CarnivalBen/dmx-eth-dimmer/pcb/plots-toner/dmx-eth-dimmer-B.Cu.pdf

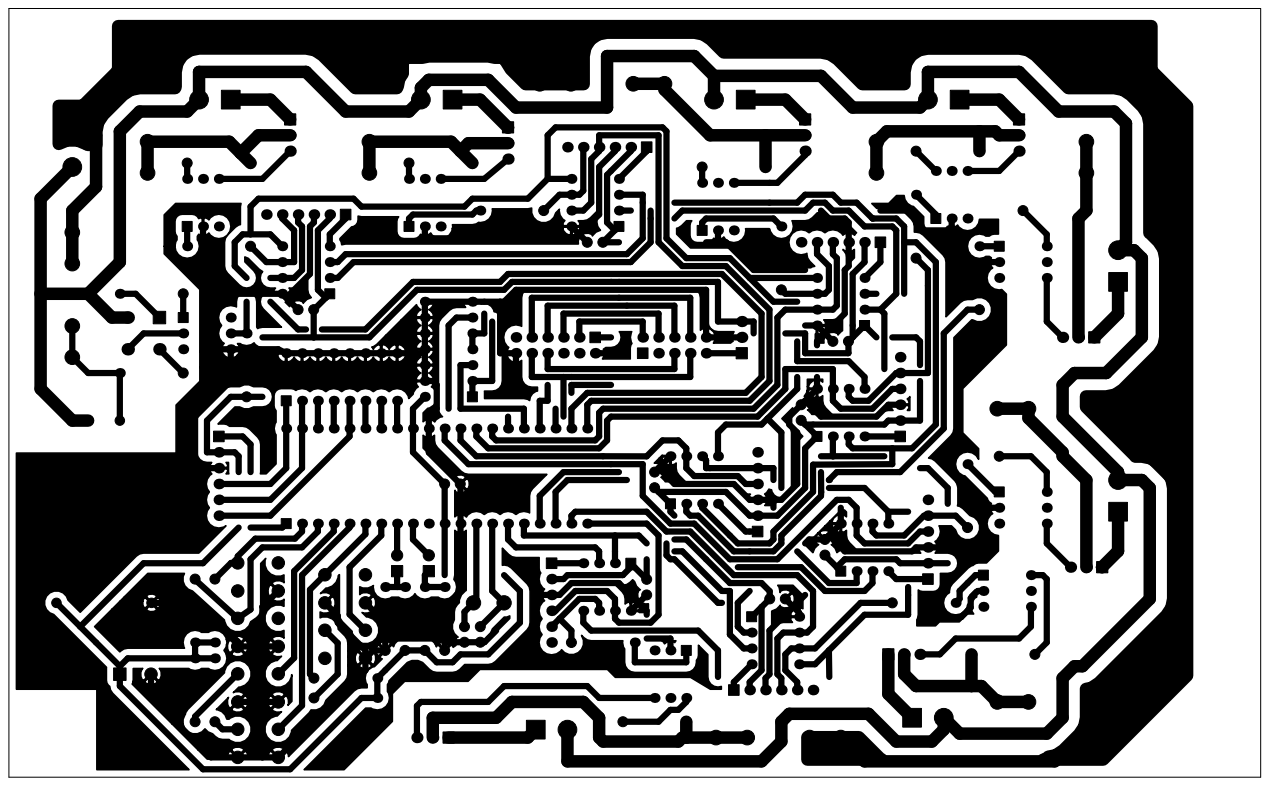
[picture p1: page 1]
