CarnivalBen/dmx-eth-dimmer/pcb/plots-toner/dmx-eth-dimmer-F.SilkS.pdf

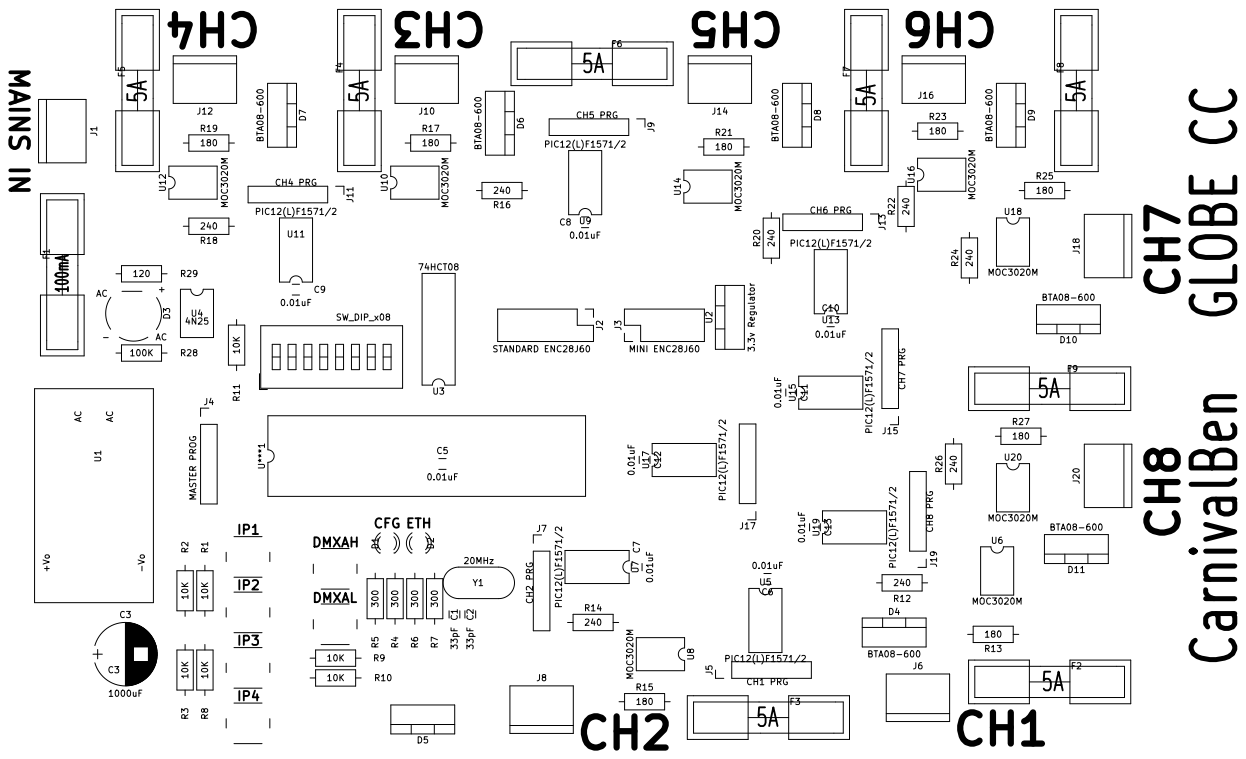
[picture p2: page 1]
