CarnivalBen/dmx-eth-dimmer/pcb/dmx-eth-dimmer.kicad_pcb

## KiCad design pcb/dmx-eth-dimmer.kicad_pcb (2018-09-09)

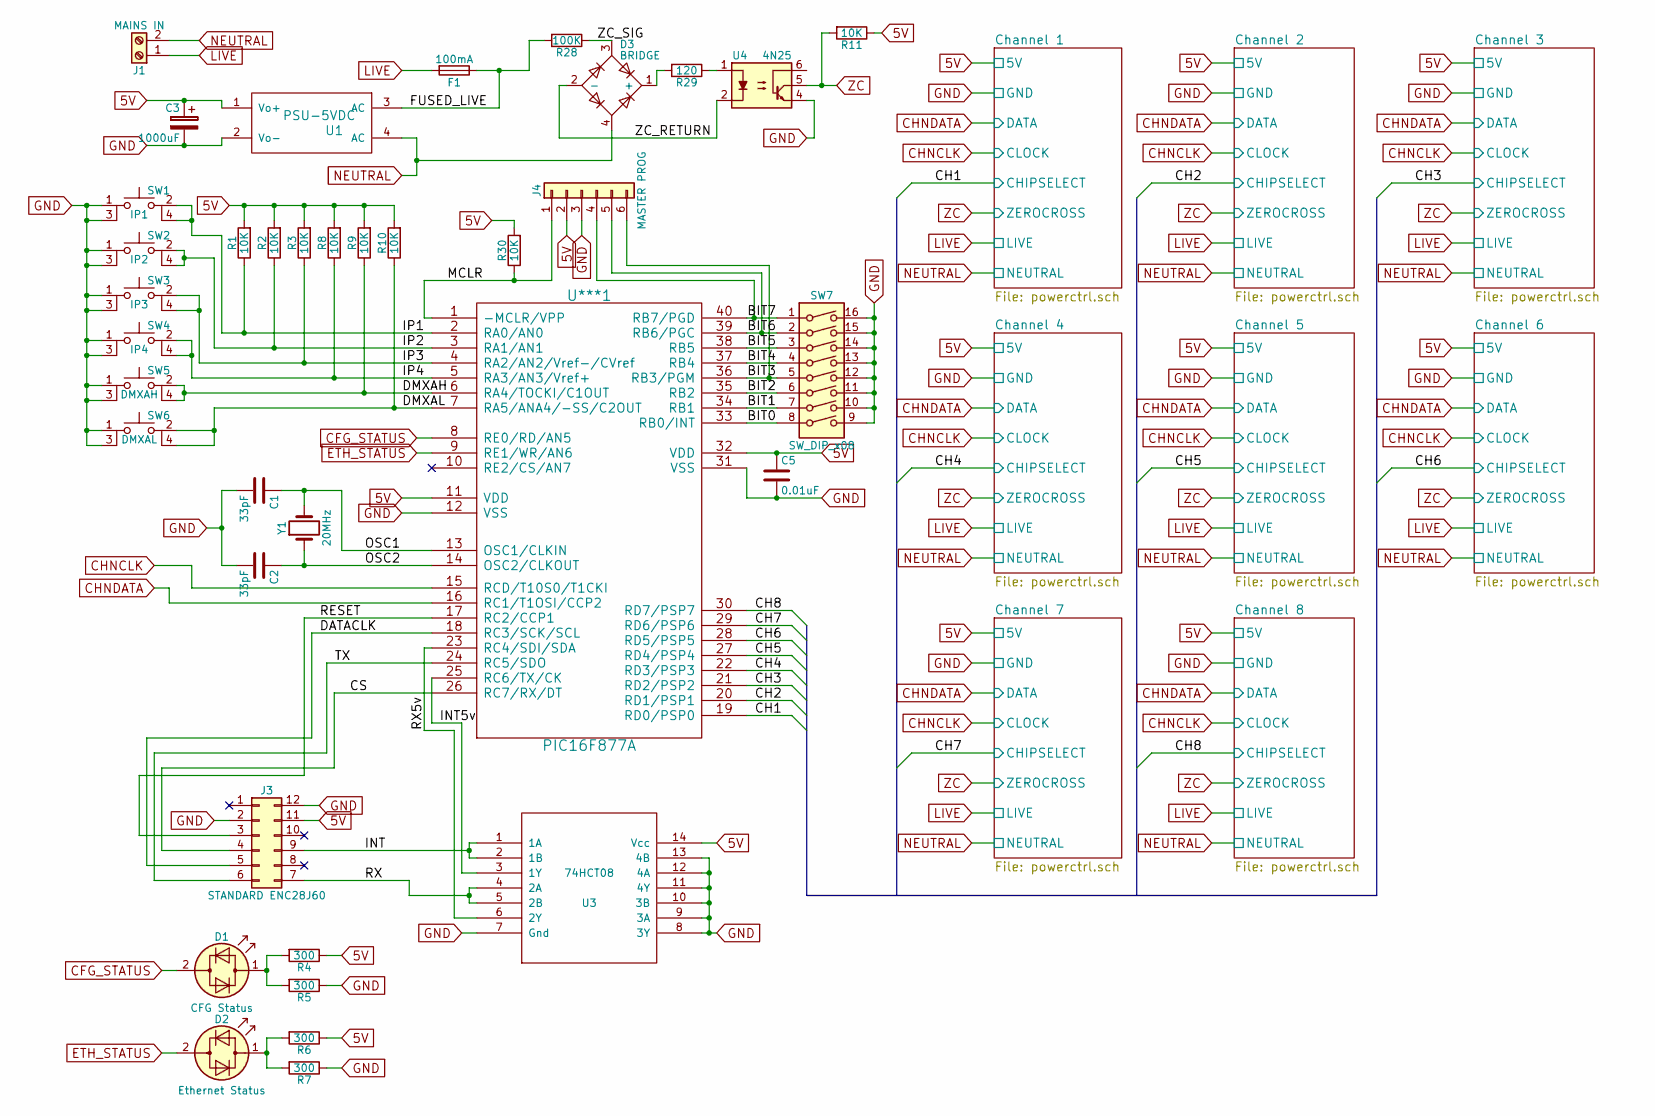
[picture p3: schematic dmx-eth-dimmer.sch]

Parts:
C1, C2: 33pF; C_Disc_D3.0mm_W1.6mm_P2.50mm
C3: 1000uF; CP_Radial_D10.0mm_P5.00mm
C5: 0.01uF; C_Disc_D3.0mm_W1.6mm_P2.50mm
D1: CFG Status; LED_D3.0mm
D2: Ethernet Status; LED_D3.0mm
D3: BRIDGE; Diode_Bridge_W08
F1: 100mA; Fuseholder5x20_horiz_open_inline_Type-I
J1: MAINS IN; TerminalBlock_bornier-2_P5.08mm
J3: STANDARD ENC28J60; Pin_Header_Straight_2x06_Pitch2.54mm
J4: MASTER PROG; Pin_Header_Straight_1x06_Pitch2.54mm
R1, R2, R3, R8, R9, R10, R11, R30: 10K; R_Axial_DIN0207_L6.3mm_D2.5mm_P10.16mm_Horizontal
R4, R5, R6, R7: 300; R_Axial_DIN0207_L6.3mm_D2.5mm_P10.16mm_Horizontal
R28: 100K; R_Axial_DIN0207_L6.3mm_D2.5mm_P10.16mm_Horizontal
R29: 120; R_Axial_DIN0207_L6.3mm_D2.5mm_P10.16mm_Horizontal
SW1: IP1; SW_PUSH_6mm_4pin
SW2: IP2; SW_PUSH_6mm_4pin
SW3: IP3; SW_PUSH_6mm_4pin
SW4: IP4; SW_PUSH_6mm_4pin
SW5: DMXAH; SW_PUSH_6mm_4pin
SW6: DMXAL; SW_PUSH_6mm_4pin
SW7: SW_DIP_x08; SW_DIP_x8_W7.62mm_Slide
U1: PSU-5VDC; HLK-PM01
U3: 74HCT08; DIP-14_W7.62mm
U4: 4N25; DIP-6_W7.62mm
U***1: PIC16F877A; DIP-40_W15.24mm
Y1: 20MHz; Crystal_HC50_Vertical

Connections:
5V: C3.1, C5.1, J3.11, J4.2, R1.2, R2.2, R3.2, R4.1, R6.1, R8.2, R9.2, R10.2, R11.1, R30.2, U1.1 (Vo+), U3.14 (Vcc), U***1.11 (VDD), U***1.32 (VDD); also elsewhere on the board
/BIT0: SW7.8, U***1.33 (RB0/INT)
/BIT1: SW7.7, U***1.34 (RB1)
/BIT2: SW7.6, U***1.35 (RB2)
/BIT3: J4.6, SW7.5, U***1.36 (RB3/PGM)
/BIT4: SW7.4, U***1.37 (RB4)
/BIT5: SW7.3, U***1.38 (RB5)
/BIT6: J4.5, SW7.2, U***1.39 (RB6/PGC)
/BIT7: J4.4, SW7.1, U***1.40 (RB7/PGD)
/CH1: U***1.19 (RD0/PSP0); also elsewhere on the board
/CH2: U***1.20 (RD1/PSP1); also elsewhere on the board
/CH3: U***1.21 (RD2/PSP2); also elsewhere on the board
/CH4: U***1.22 (RD3/PSP3); also elsewhere on the board
/CH5: U***1.27 (RD4/PSP4); also elsewhere on the board
/CH6: U***1.28 (RD5/PSP5); also elsewhere on the board
/CH7: U***1.29 (RD6/PSP6); also elsewhere on the board
/CH8: U***1.30 (RD7/PSP7); also elsewhere on the board
/CS: J3.4, U***1.26 (RC7/RX/DT)
/DATACLK: J3.5, U***1.18 (RC3/SCK/SCL)
/DMXAH: R9.1, SW5.2, SW5.4, U***1.6 (RA4/TOCKI/C1OUT)
/DMXAL: R10.1, SW6.2, SW6.4, U***1.7 (RA5/ANA4/-SS/C2OUT)
/FUSED_LIVE: F1.1, R28.2, U1.3 (AC)
/INT: J3.9, U3.1 (1A), U3.2 (1B)
/INT5v: U3.3 (1Y), U***1.25 (RC6/TX/CK)
/IP1: R1.1, SW1.2, SW1.4, U***1.2 (RA0/AN0)
/IP2: R2.1, SW2.2, SW2.4, U***1.3 (RA1/AN1)
/IP3: R3.1, SW3.2, SW3.4, U***1.4 (RA2/AN2/Vref-/CVref)
/IP4: R8.1, SW4.2, SW4.4, U***1.5 (RA3/AN3/Vref+)
/MCLR: J4.1, R30.1, U***1.1 (-MCLR/VPP)
/OSC1: C1.1, U***1.13 (OSC1/CLKIN), Y1.2
/OSC2: C2.1, U***1.14 (OSC2/CLKOUT), Y1.1
/RESET: J3.3, U***1.17 (RC2/CCP1)
/RX: J3.7, U3.4 (2A), U3.5 (2B)
/RX5v: U3.6 (2Y), U***1.23 (RC4/SDI/SDA)
/TX: J3.6, U***1.24 (RC5/SDO)
/ZC_RETURN: D3.2 (-), U4.2
/ZC_SIG: D3.3, R28.1
CFG_STATUS: D1.2 (AK), U***1.8 (RE0/RD/AN5)
CHNCLK: U***1.15 (RCD/T10S0/T1CKI); also elsewhere on the board
CHNDATA: U***1.16 (RC1/T1OSI/CCP2); also elsewhere on the board
ETH_STATUS: D2.2 (AK), U***1.9 (RE1/WR/AN6)
GND: C1.2, C2.2, C3.2, C5.2, J3.2, J3.12, J4.3, R5.1, R7.1, SW1.1, SW1.3, SW2.1, SW2.3, SW3.1, SW3.3, SW4.1, SW4.3, SW5.1, SW5.3, SW6.1, SW6.3, SW7.9, SW7.10, SW7.11, SW7.12, SW7.13, SW7.14, SW7.15, SW7.16, U1.2 (Vo-), U3.7 (Gnd), U3.8 (3Y), U3.9 (3A), U3.10 (3B), U3.11 (4Y), U3.12 (4A), U3.13 (4B), U4.4, U***1.12 (VSS), U***1.31 (VSS); also elsewhere on the board
LIVE: F1.2, J1.1; also elsewhere on the board
NEUTRAL: D3.4, J1.2, U1.4 (AC); also elsewhere on the board
unnamed: D1.1 (KA), R4.2, R5.2
unnamed: D2.1 (KA), R6.2, R7.2
unnamed: D3.1 (+), R29.2
unnamed: R29.1, U4.1
ZC: R11.2, U4.5; also elsewhere on the board

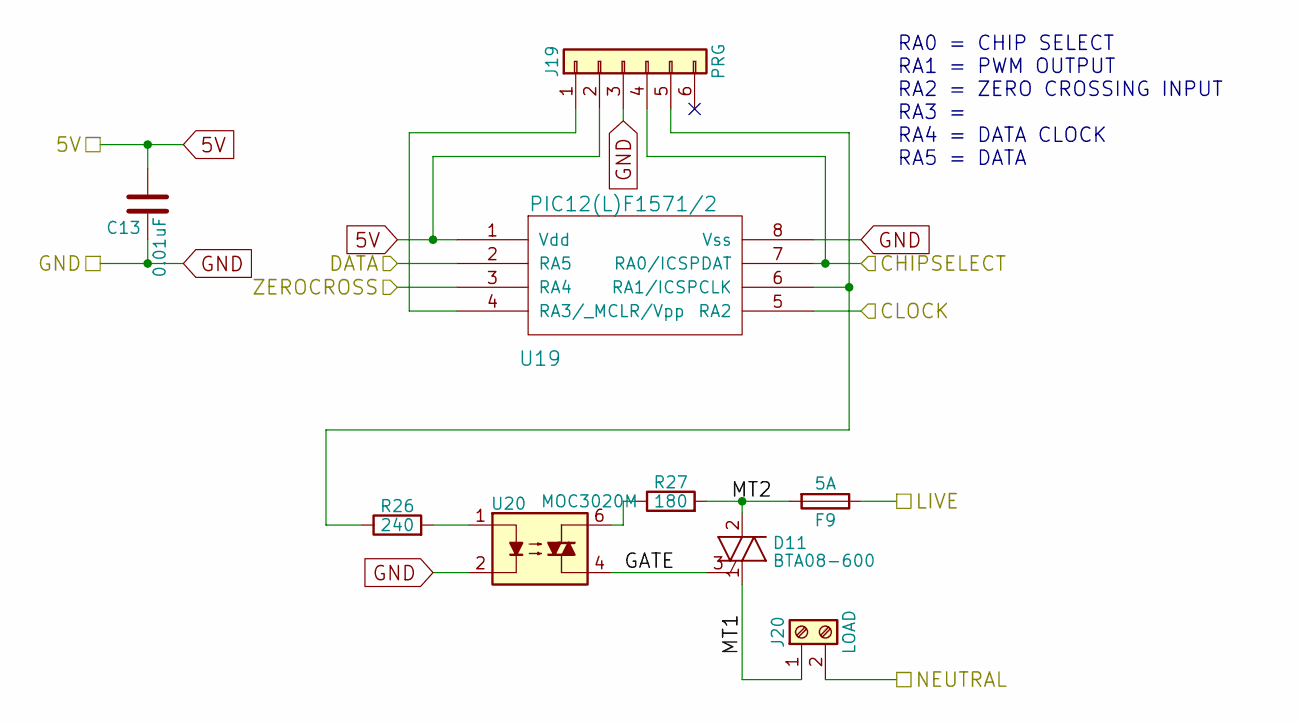
[picture p4: schematic powerctrl.sch]

Parts:
C6: 0.01uF; C_Disc_D3.0mm_W1.6mm_P2.50mm
D4: BTA08-600; TO-220-3_Vertical
F2: 5A; Fuseholder5x20_horiz_open_inline_Type-I
J5: PRG; Pin_Header_Straight_1x06_Pitch2.54mm
J6: LOAD; TerminalBlock_bornier-2_P5.08mm
R12: 240; R_Axial_DIN0207_L6.3mm_D2.5mm_P10.16mm_Horizontal
R13: 180; R_Axial_DIN0207_L6.3mm_D2.5mm_P10.16mm_Horizontal
U5: PIC12(L)F1571/2; DIP-8_W7.62mm
U6: MOC3020M; DIP-6_W7.62mm

Connections:
5V: C6.2, J5.2, U5.1 (Vdd); also elsewhere on the board
/CH1: J5.4, U5.7 (RA0/ICSPDAT); also elsewhere on the board
/Channel 1/GATE: D4.3 (G), U6.4
/Channel 1/MT1: D4.1 (MT1), J6.1
/Channel 1/MT2: D4.2 (MT2), F2.2, R13.2
CHNCLK: U5.5 (RA2); also elsewhere on the board
CHNDATA: U5.2 (RA5); also elsewhere on the board
GND: C6.1, J5.3, U5.8 (Vss), U6.2; also elsewhere on the board
LIVE: F2.1; also elsewhere on the board
NEUTRAL: J6.2; also elsewhere on the board
unnamed: J5.1, U5.4 (RA3/_MCLR/Vpp)
unnamed: J5.5, R12.1, U5.6 (RA1/ICSPCLK)
unnamed: R12.2, U6.1
unnamed: R13.1, U6.6
ZC: U5.3 (RA4); also elsewhere on the board

Parts of its further copies:
C7, C8, C9, C10, C11, C12, C13: 0.01uF; C_Disc_D3.0mm_W1.6mm_P2.50mm
D5, D6, D7, D8, D9, D10, D11: BTA08-600; TO-220-3_Vertical
F3, F4, F5, F6, F7, F8, F9: 5A; Fuseholder5x20_horiz_open_inline_Type-I
J7, J9, J11, J13, J15, J17, J19: PRG; Pin_Header_Straight_1x06_Pitch2.54mm
J8, J10, J12, J14, J16, J18, J20: LOAD; TerminalBlock_bornier-2_P5.08mm
R14, R16, R18, R20, R22, R24, R26: 240; R_Axial_DIN0207_L6.3mm_D2.5mm_P10.16mm_Horizontal
R15, R17, R19, R21, R23, R25, R27: 180; R_Axial_DIN0207_L6.3mm_D2.5mm_P10.16mm_Horizontal
U7, U9, U11, U13, U15, U17, U19: PIC12(L)F1571/2; DIP-8_W7.62mm
U8, U10, U12, U14, U16, U18, U20: MOC3020M; DIP-6_W7.62mm

Connections of its further copies:
5V: C7.2, C8.2, C9.2, C10.2, C11.2, C12.2, C13.2, J7.2, J9.2, J11.2, J13.2, J15.2, J17.2, J19.2, U7.1 (Vdd), U9.1 (Vdd), U11.1 (Vdd), U13.1 (Vdd), U15.1 (Vdd), U17.1 (Vdd), U19.1 (Vdd); also elsewhere on the board
/CH2: J7.4, U7.7 (RA0/ICSPDAT); also elsewhere on the board
/CH3: J9.4, U9.7 (RA0/ICSPDAT); also elsewhere on the board
/CH4: J11.4, U11.7 (RA0/ICSPDAT); also elsewhere on the board
/CH5: J13.4, U13.7 (RA0/ICSPDAT); also elsewhere on the board
/CH6: J15.4, U15.7 (RA0/ICSPDAT); also elsewhere on the board
/CH7: J17.4, U17.7 (RA0/ICSPDAT); also elsewhere on the board
/CH8: J19.4, U19.7 (RA0/ICSPDAT); also elsewhere on the board
/Channel 2/GATE: D5.3 (G), U8.4
/Channel 2/MT1: D5.1 (MT1), J8.1
/Channel 2/MT2: D5.2 (MT2), F3.2, R15.2
/Channel 3/GATE: D6.3 (G), U10.4
/Channel 3/MT1: D6.1 (MT1), J10.1
/Channel 3/MT2: D6.2 (MT2), F4.2, R17.2
/Channel 4/GATE: D7.3 (G), U12.4
/Channel 4/MT1: D7.1 (MT1), J12.1
/Channel 4/MT2: D7.2 (MT2), F5.2, R19.2
/Channel 5/GATE: D8.3 (G), U14.4
/Channel 5/MT1: D8.1 (MT1), J14.1
/Channel 5/MT2: D8.2 (MT2), F6.2, R21.2
/Channel 6/GATE: D9.3 (G), U16.4
/Channel 6/MT1: D9.1 (MT1), J16.1
/Channel 6/MT2: D9.2 (MT2), F7.2, R23.2
/Channel 7/GATE: D10.3 (G), U18.4
/Channel 7/MT1: D10.1 (MT1), J18.1
/Channel 7/MT2: D10.2 (MT2), F8.2, R25.2
/Channel 8/GATE: D11.3 (G), U20.4
/Channel 8/MT1: D11.1 (MT1), J20.1
/Channel 8/MT2: D11.2 (MT2), F9.2, R27.2
CHNCLK: U7.5 (RA2), U9.5 (RA2), U11.5 (RA2), U13.5 (RA2), U15.5 (RA2), U17.5 (RA2), U19.5 (RA2); also elsewhere on the board
CHNDATA: U7.2 (RA5), U9.2 (RA5), U11.2 (RA5), U13.2 (RA5), U15.2 (RA5), U17.2 (RA5), U19.2 (RA5); also elsewhere on the board
GND: C7.1, C8.1, C9.1, C10.1, C11.1, C12.1, C13.1, J7.3, J9.3, J11.3, J13.3, J15.3, J17.3, J19.3, U7.8 (Vss), U8.2, U9.8 (Vss), U10.2, U11.8 (Vss), U12.2, U13.8 (Vss), U14.2, U15.8 (Vss), U16.2, U17.8 (Vss), U18.2, U19.8 (Vss), U20.2; also elsewhere on the board
LIVE: F3.1, F4.1, F5.1, F6.1, F7.1, F8.1, F9.1; also elsewhere on the board
NEUTRAL: J8.2, J10.2, J12.2, J14.2, J16.2, J18.2, J20.2; also elsewhere on the board
unnamed: J7.1, U7.4 (RA3/_MCLR/Vpp)
unnamed: J7.5, R14.1, U7.6 (RA1/ICSPCLK)
unnamed: J9.1, U9.4 (RA3/_MCLR/Vpp)
unnamed: J9.5, R16.1, U9.6 (RA1/ICSPCLK)
unnamed: J11.1, U11.4 (RA3/_MCLR/Vpp)
unnamed: J11.5, R18.1, U11.6 (RA1/ICSPCLK)
unnamed: J13.1, U13.4 (RA3/_MCLR/Vpp)
unnamed: J13.5, R20.1, U13.6 (RA1/ICSPCLK)
unnamed: J15.1, U15.4 (RA3/_MCLR/Vpp)
unnamed: J15.5, R22.1, U15.6 (RA1/ICSPCLK)
unnamed: J17.1, U17.4 (RA3/_MCLR/Vpp)
unnamed: J17.5, R24.1, U17.6 (RA1/ICSPCLK)
unnamed: J19.1, U19.4 (RA3/_MCLR/Vpp)
unnamed: J19.5, R26.1, U19.6 (RA1/ICSPCLK)
unnamed: R14.2, U8.1
unnamed: R15.1, U8.6
unnamed: R16.2, U10.1
unnamed: R17.1, U10.6
unnamed: R18.2, U12.1
unnamed: R19.1, U12.6
unnamed: R20.2, U14.1
unnamed: R21.1, U14.6
unnamed: R22.2, U16.1
unnamed: R23.1, U16.6
unnamed: R24.2, U18.1
unnamed: R25.1, U18.6
unnamed: R26.2, U20.1
unnamed: R27.1, U20.6
ZC: U7.3 (RA4), U9.3 (RA4), U11.3 (RA4), U13.3 (RA4), U15.3 (RA4), U17.3 (RA4), U19.3 (RA4); also elsewhere on the board

Notes on the sheet:
RA0 = CHIP SELECT RA1 = PWM OUTPUT RA2 = ZERO CROSSING INPUT RA3 = RA4 = DATA CLOCK RA5 = DATA

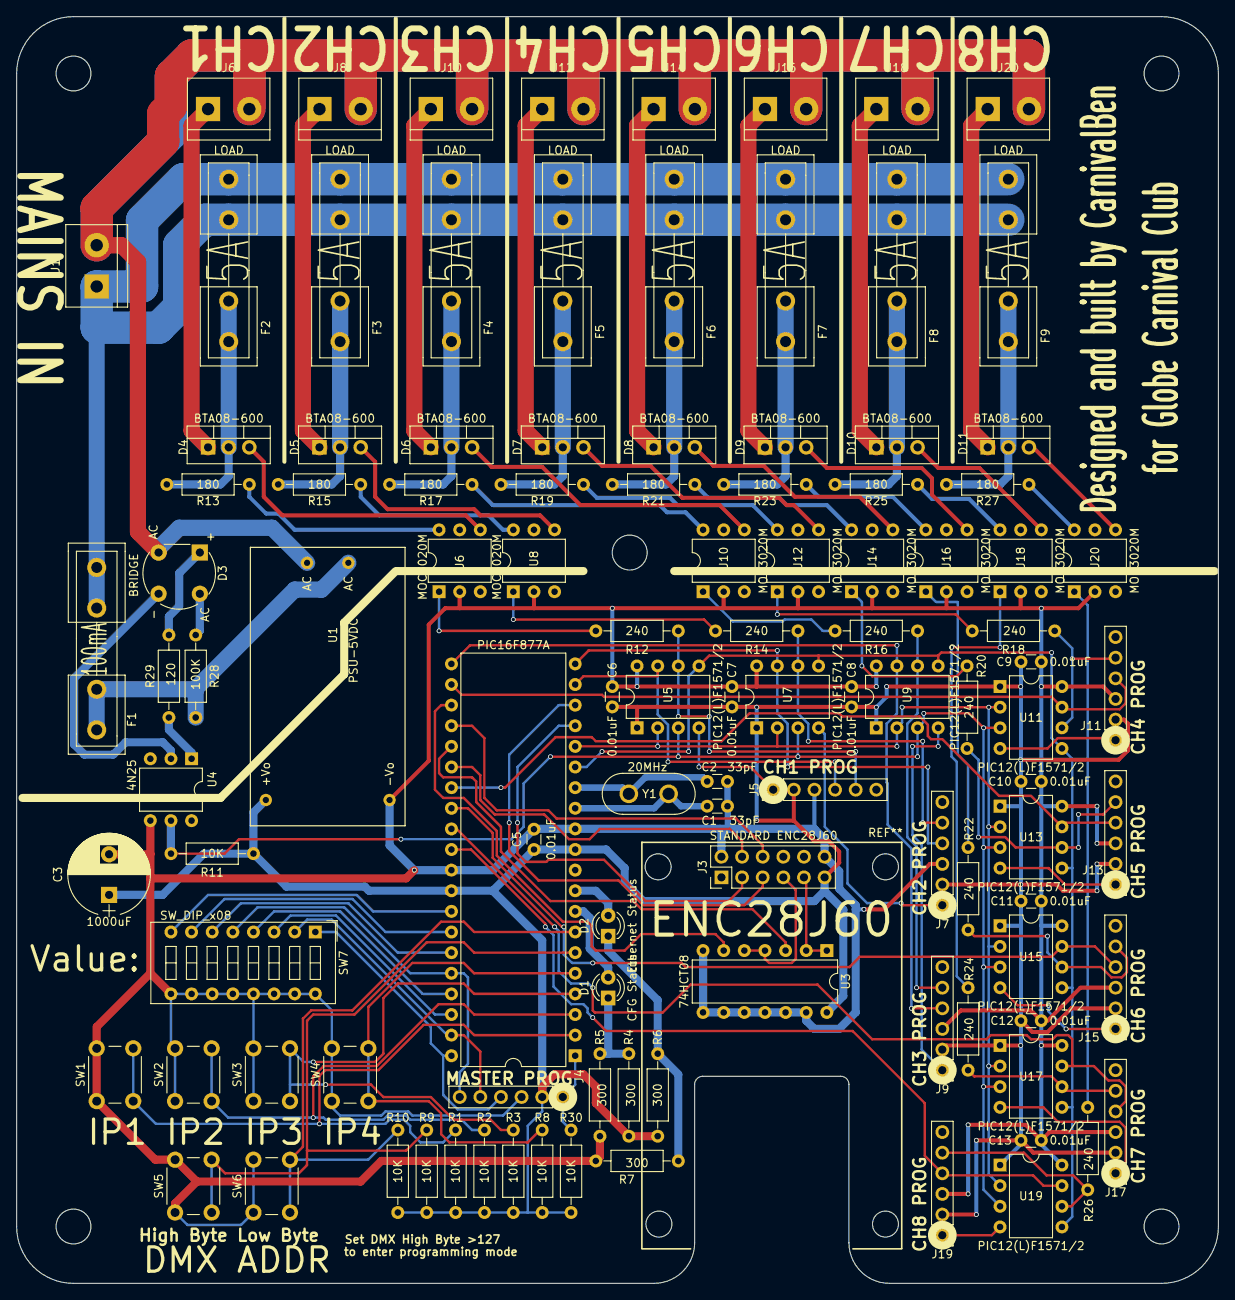
[picture p5: board dmx-eth-dimmer.kicad_pcb from above]

Board: 2 copper layers, 148.0 x 156.0 mm, 109 parts (0 on the bottom side), 105 nets.
