CarnivalBen/dmx-eth-dimmer/(commit log)

2018-06-18 Update to PCB
    [dmx-eth-dimmer-B.Cu.gbr, dmx-eth-dimmer-B.Mask.gbr, dmx-eth-dimmer-B.SilkS.gbr, dmx-eth-dimmer-Edge.Cuts.gbr, dmx-eth-dimmer-F.Cu.gbr, dmx-eth-dimmer-F.Mask.gbr, dmx-eth-dimmer-F.SilkS.gbr, dmx-eth-dimmer-NPTH.drl]
2018-06-26 Updated PCB
    [dmx-eth-dimmer-B.Cu.gbr, dmx-eth-dimmer-B.Mask.gbr, dmx-eth-dimmer-B.SilkS.gbr, dmx-eth-dimmer-Edge.Cuts.gbr, dmx-eth-dimmer-F.Cu.gbr, dmx-eth-dimmer-F.Mask.gbr, dmx-eth-dimmer-F.SilkS.gbr, dmx-eth-dimmer-NPTH.drl]
2018-07-29 PWM1/TMR1 version
    [Timings.xlsx, dmx-eth-dimmer.kicad_pcb, dmx-eth-dimmer.sch, powerctrl.sch]
2018-07-30 Final version of dmx/ethernet controller board.
2018-08-15 New PCB Layout
    [dmx-eth-dimmer-B.Cu.gbr, dmx-eth-dimmer-B.Mask.gbr, dmx-eth-dimmer-B.SilkS.gbr, dmx-eth-dimmer-Edge.Cuts.gbr, dmx-eth-dimmer-F.Cu.gbr, dmx-eth-dimmer-F.Mask.gbr, dmx-eth-dimmer-F.SilkS.gbr, dmx-eth-dimmer-NPTH.drl]
2018-09-09 Added Gerbers and watchdog
    [dmx-eth-dimmer-B.Cu.gbr, dmx-eth-dimmer-B.Mask.gbr, dmx-eth-dimmer-B.SilkS.gbr, dmx-eth-dimmer-Edge.Cuts.gbr, dmx-eth-dimmer-F.Cu.gbr, dmx-eth-dimmer-F.Mask.gbr, dmx-eth-dimmer-F.SilkS.gbr, dmx-eth-dimmer-NPTH.drl]
